FrancoBisciglia/ProyectoFinal_PCB_Prototipo/README.md

# ProyectoFinal_PCB_Prototipo
 PCB de la placa prototipo del Sistema de Automatización para Huertas Hidropónicas NFT
