FrancoBisciglia/ProyectoFinal_PCB_Prototipo/PCB_Prototipo_Proyecto_Final.kicad_pcb

## KiCad design PCB_Prototipo_Proyecto_Final.kicad_pcb (2023-03-13)

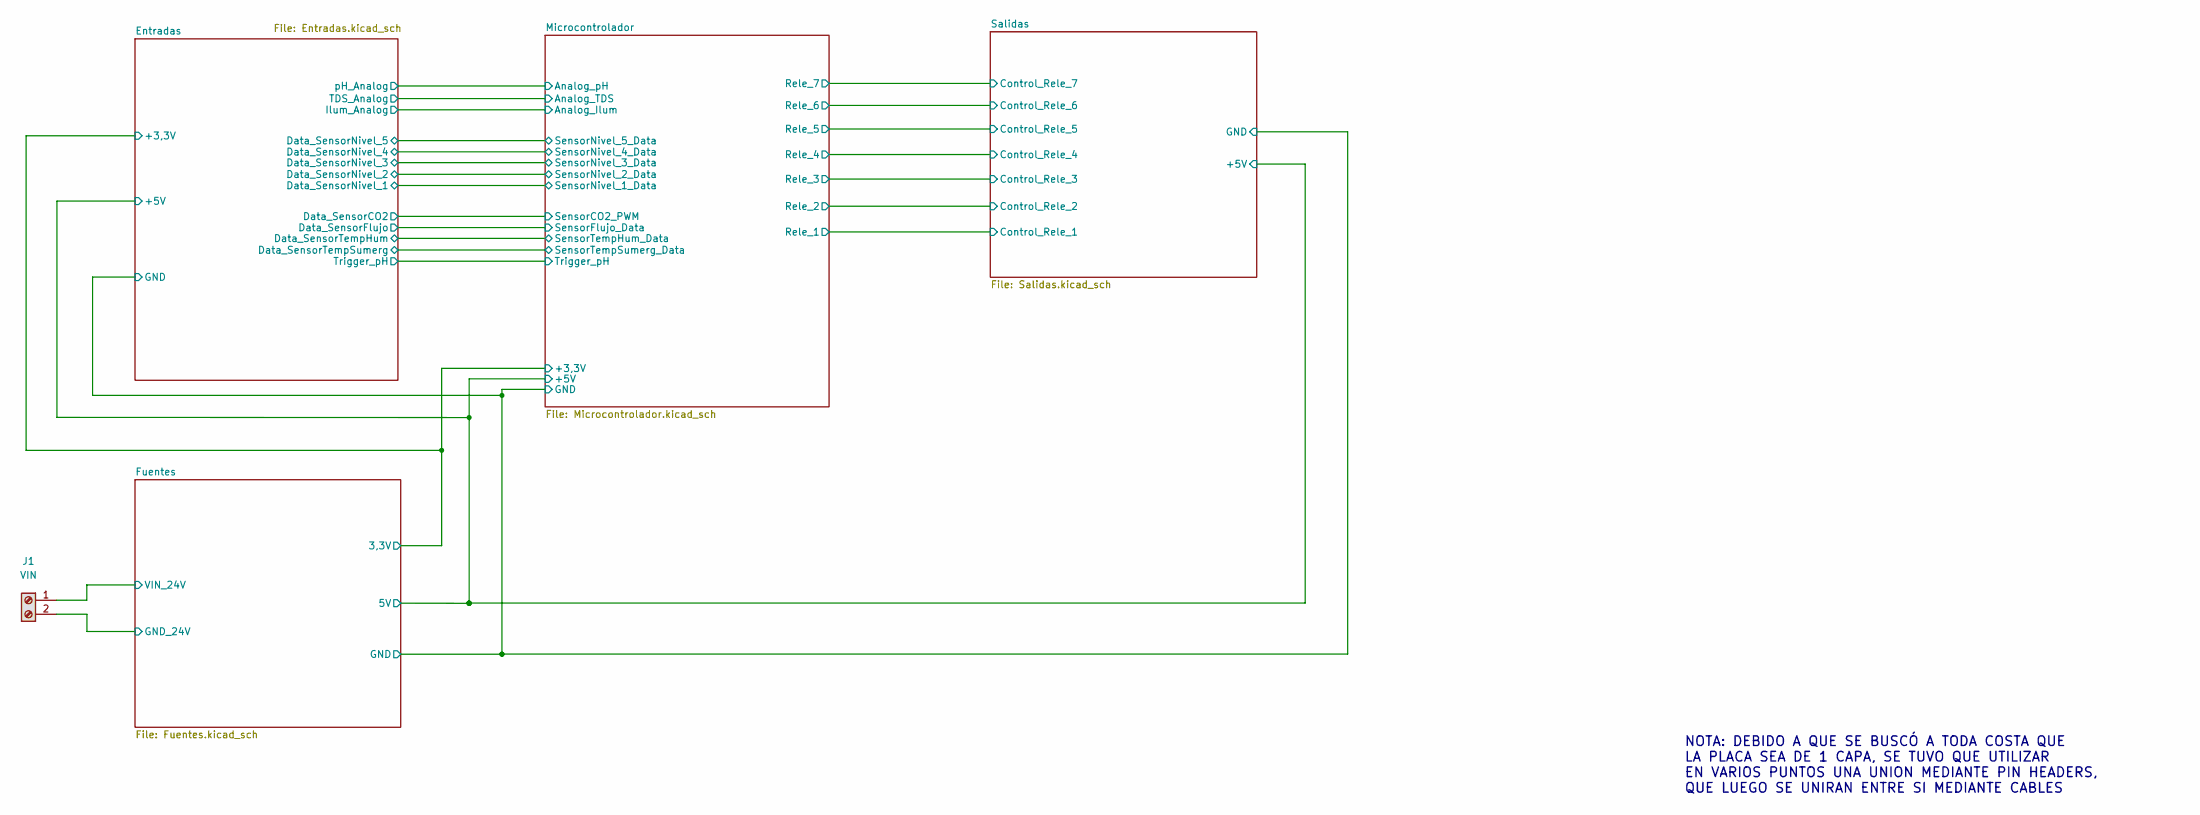
[picture p1: schematic PCB_Prototipo_Proyecto_Final.kicad_sch]

Parts:
J1: VIN; TB00250002BE

Connections:
/Fuentes/VIN_24V: J1.1; also elsewhere on the board
GND: J1.2; also elsewhere on the board

Notes on the sheet:
NOTA: DEBIDO A QUE SE BUSCÓ A TODA COSTA QUE LA PLACA SEA DE 1 CAPA, SE TUVO QUE UTILIZAR EN VARIOS PUNTOS UNA UNION MEDIANTE PIN HEADERS, QUE LUEGO SE UNIRAN ENTRE SI MEDIANTE CABLES

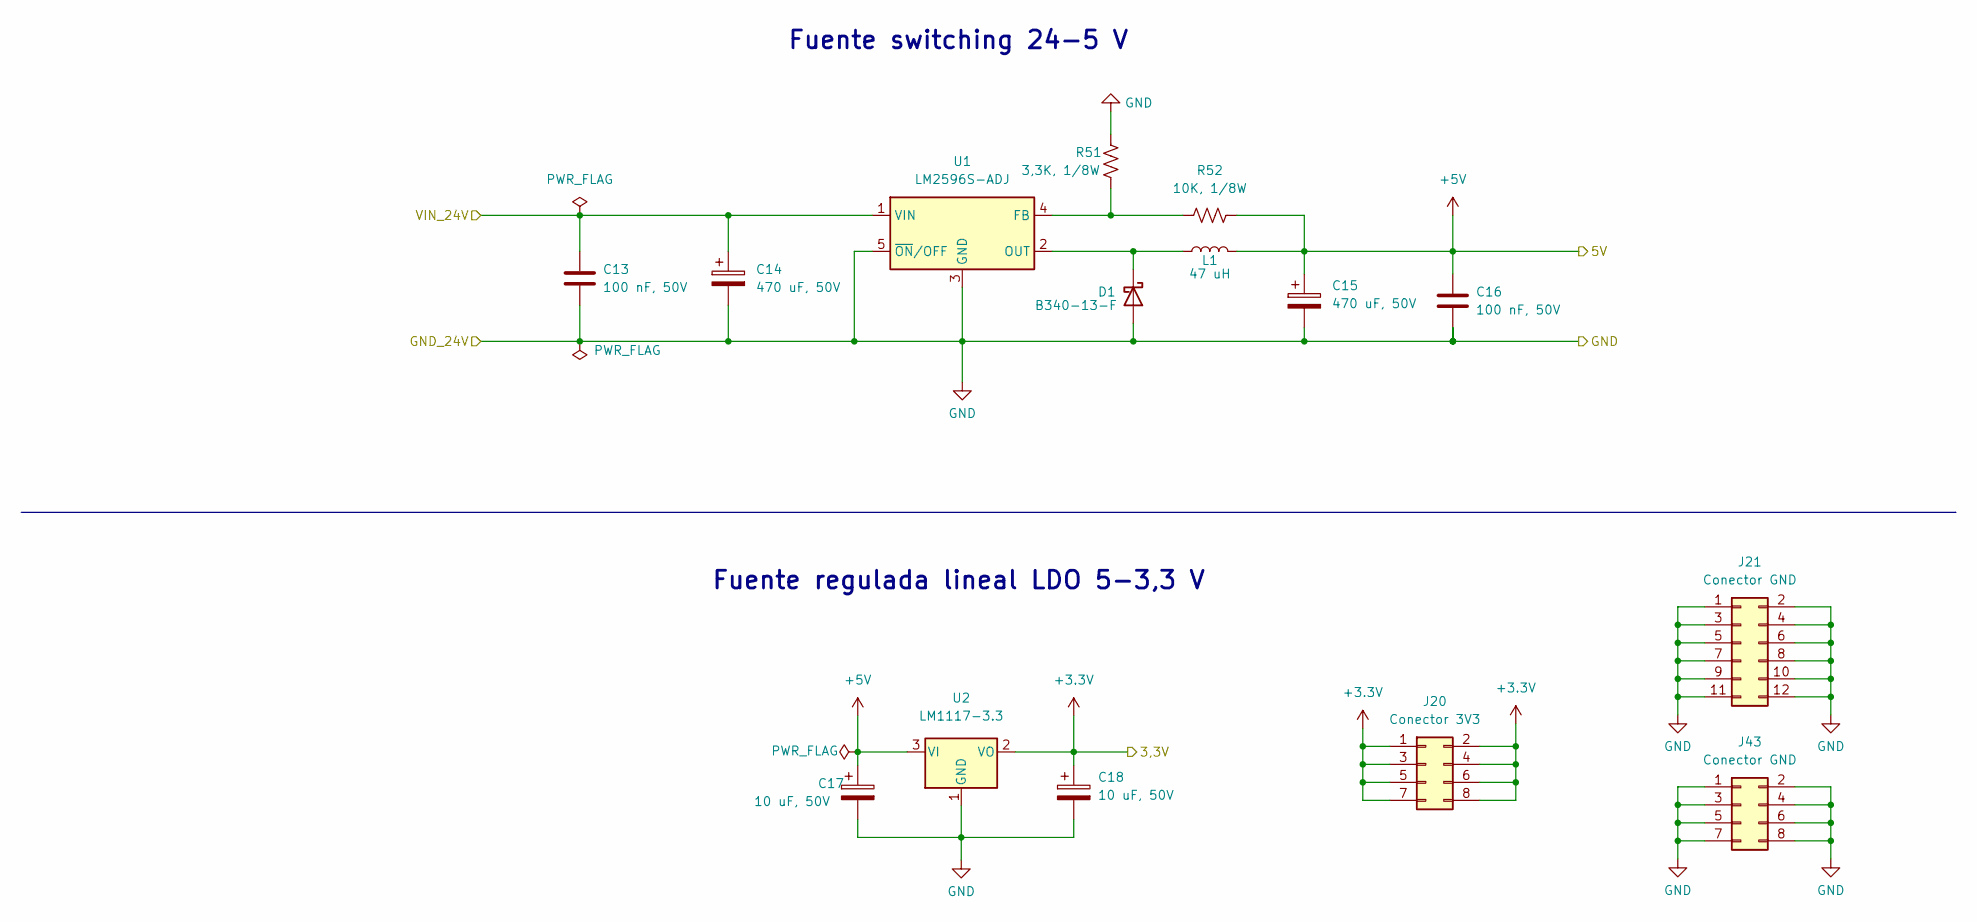
[picture p2: schematic Fuentes.kicad_sch]

Parts:
C13, C16: 100 nF, 50V; C_0805_2012Metric
C14, C15: 470 uF, 50V; CP_Radial_D10.0mm_P5.00mm
C17, C18: 10 uF, 50V; CP_Radial_D5.0mm_P2.00mm
D1: B340-13-F; DIOM7959X250N
J20: Conector 3V3; PinHeader_2x04_P2.54mm_Vertical
J21: Conector GND; PinHeader_2x06_P2.54mm_Vertical
J43: Conector GND; PinHeader_2x04_P2.54mm_Vertical
L1: 47 uH; L_Radial_D7.5mm_P5.00mm_Fastron_07P
R51: 3,3K, 1/8W; R_0805_2012Metric
R52: 10K, 1/8W; R_0805_2012Metric
U1: LM2596S-ADJ; LM2596SXADJNOPB
U2: LM1117-3.3; SOT230P700X180-4N

Connections:
+3.3V: C18.1, J20.1, J20.2, J20.3, J20.4, J20.5, J20.6, J20.7, J20.8, U2.2 (VO); also elsewhere on the board
+5V: C15.1, C16.1, C17.1, L1.2, R52.2, U2.3 (VI); also elsewhere on the board
/Fuentes/VIN_24V: C13.1, C14.1, U1.1 (VIN); also elsewhere on the board
GND: C13.2, C14.2, C15.2, C16.2, C17.2, C18.2, D1.2 (A), J21.1, J21.2, J21.3, J21.4, J21.5, J21.6, J21.7, J21.8, J21.9, J21.10, J21.11, J21.12, J43.1, J43.2, J43.3, J43.4, J43.5, J43.6, J43.7, J43.8, R51.1, U1.3 (GND), U1.5 (~ON/OFF), U2.1 (GND); also elsewhere on the board
unnamed: D1.1 (K), L1.1, U1.2 (OUT)
unnamed: R51.2, R52.1, U1.4 (FB)

Notes on the sheet:
Fuente switching 24-5 V
Fuente regulada lineal LDO 5-3,3 V

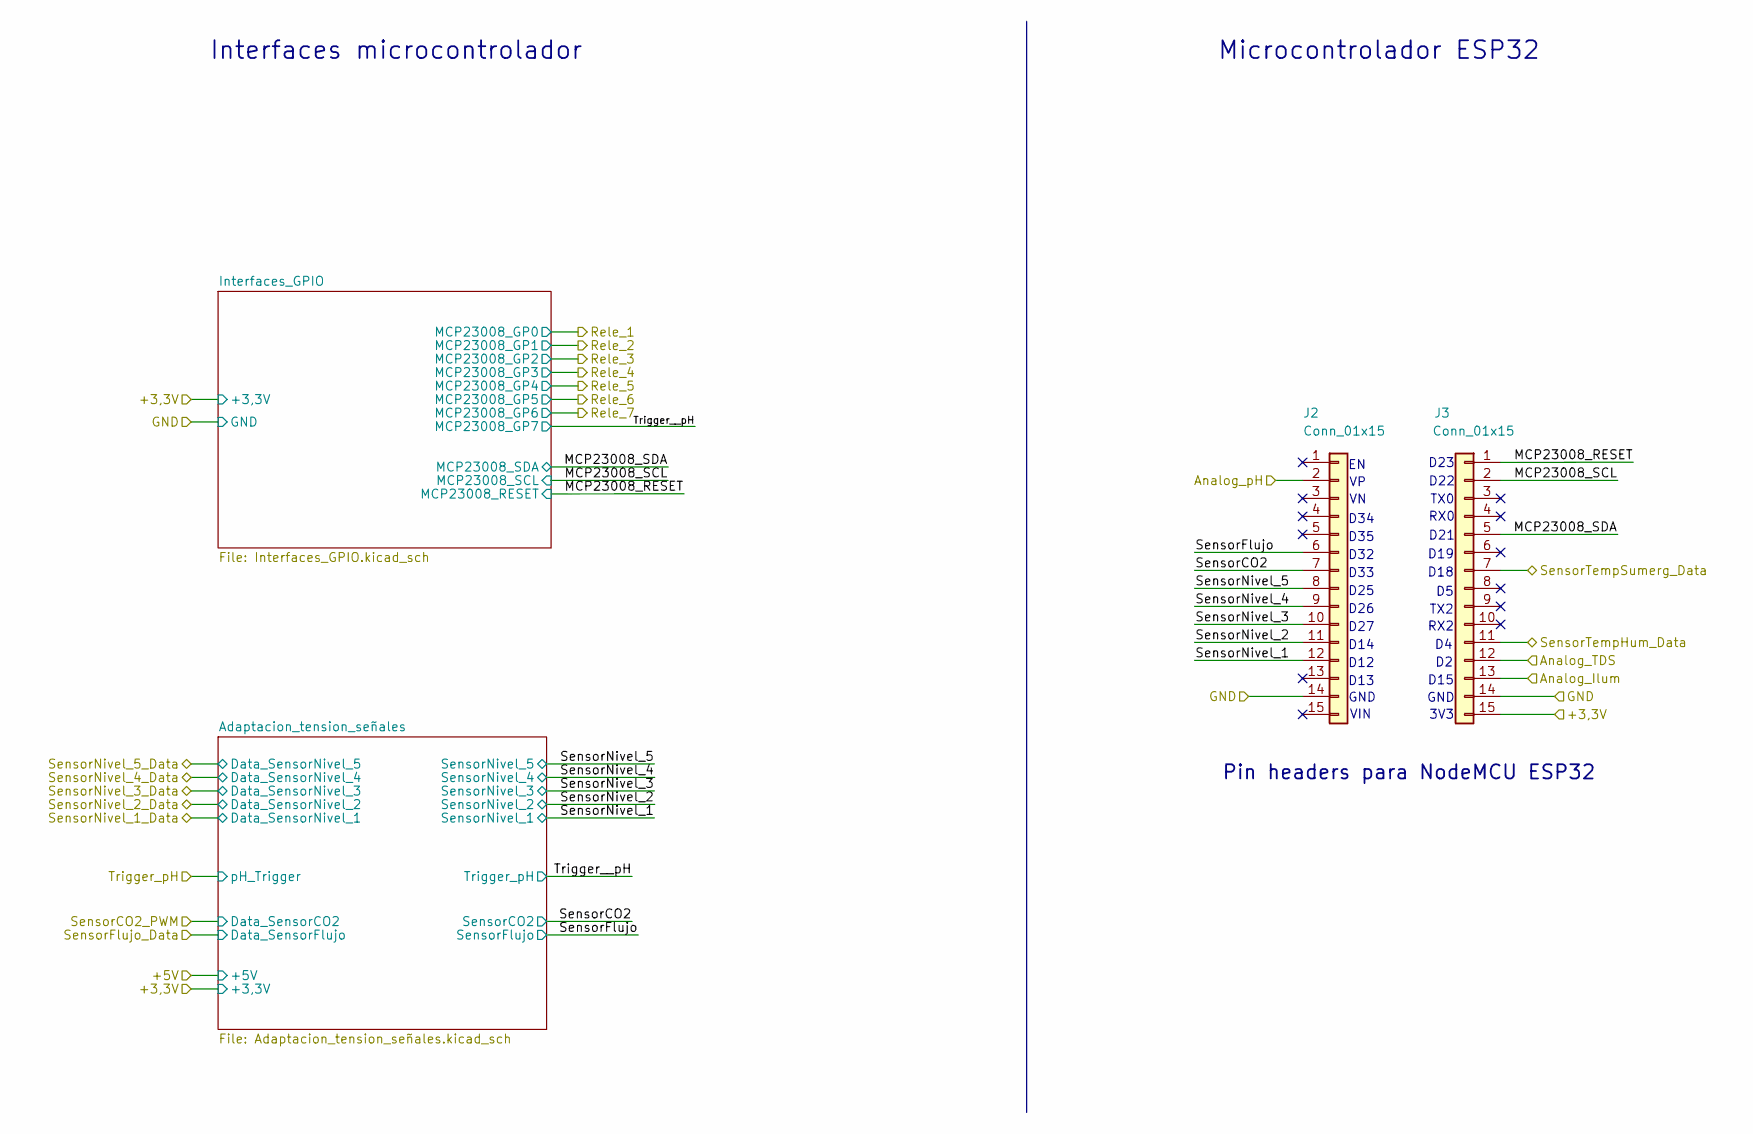
[picture p3: schematic Microcontrolador.kicad_sch]

Parts:
J2, J3: Conn_01x15; PinHeader_1x15_P2.54mm_Vertical

Connections:
+3.3V: J3.15; also elsewhere on the board
/Entradas/Data_SensorTempHum: J3.11; also elsewhere on the board
/Entradas/Data_SensorTempSumerg: J3.7; also elsewhere on the board
/Entradas/Ilum_Analog: J3.13; also elsewhere on the board
/Entradas/TDS_Analog: J3.12; also elsewhere on the board
/Entradas/pH_Analog: J2.2; also elsewhere on the board
/Microcontrolador/MCP23008_RESET: J3.1; also elsewhere on the board
/Microcontrolador/MCP23008_SCL: J3.2; also elsewhere on the board
/Microcontrolador/MCP23008_SDA: J3.5; also elsewhere on the board
/Microcontrolador/SensorCO2: J2.7; also elsewhere on the board
/Microcontrolador/SensorFlujo: J2.6; also elsewhere on the board
/Microcontrolador/SensorNivel_1: J2.12; also elsewhere on the board
/Microcontrolador/SensorNivel_2: J2.11; also elsewhere on the board
/Microcontrolador/SensorNivel_3: J2.10; also elsewhere on the board
/Microcontrolador/SensorNivel_4: J2.9; also elsewhere on the board
/Microcontrolador/SensorNivel_5: J2.8; also elsewhere on the board
GND: J2.14, J3.14; also elsewhere on the board

Notes on the sheet:
GND
RX2
D35
D32
D26
Microcontrolador ESP32
VIN
D18
3V3
D15
D25
D27
Interfaces microcontrolador
RX0
D34
D21
D22
D14
D13
TX0
D12
TX2
D19
D23
D33
Pin headers para NodeMCU ESP32

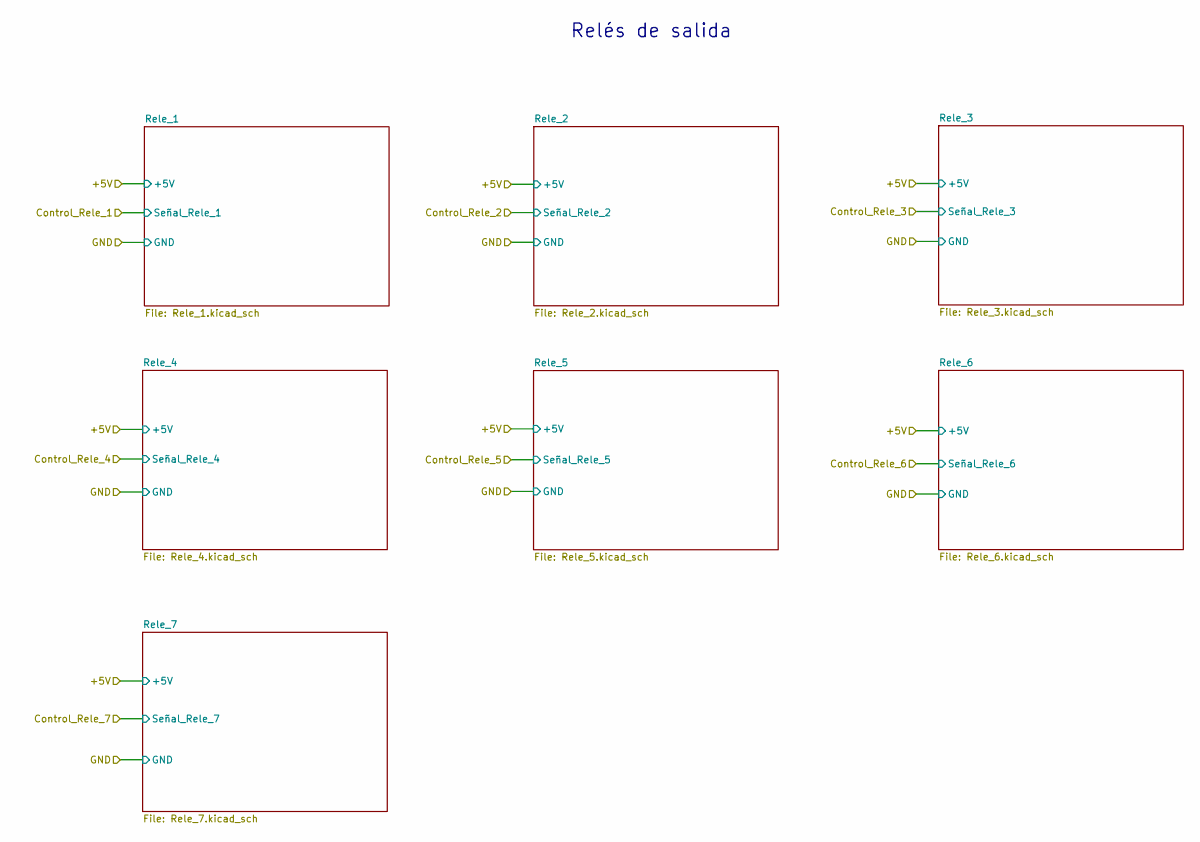
[picture p4: schematic Salidas.kicad_sch]

Notes on the sheet:
Relés de salida

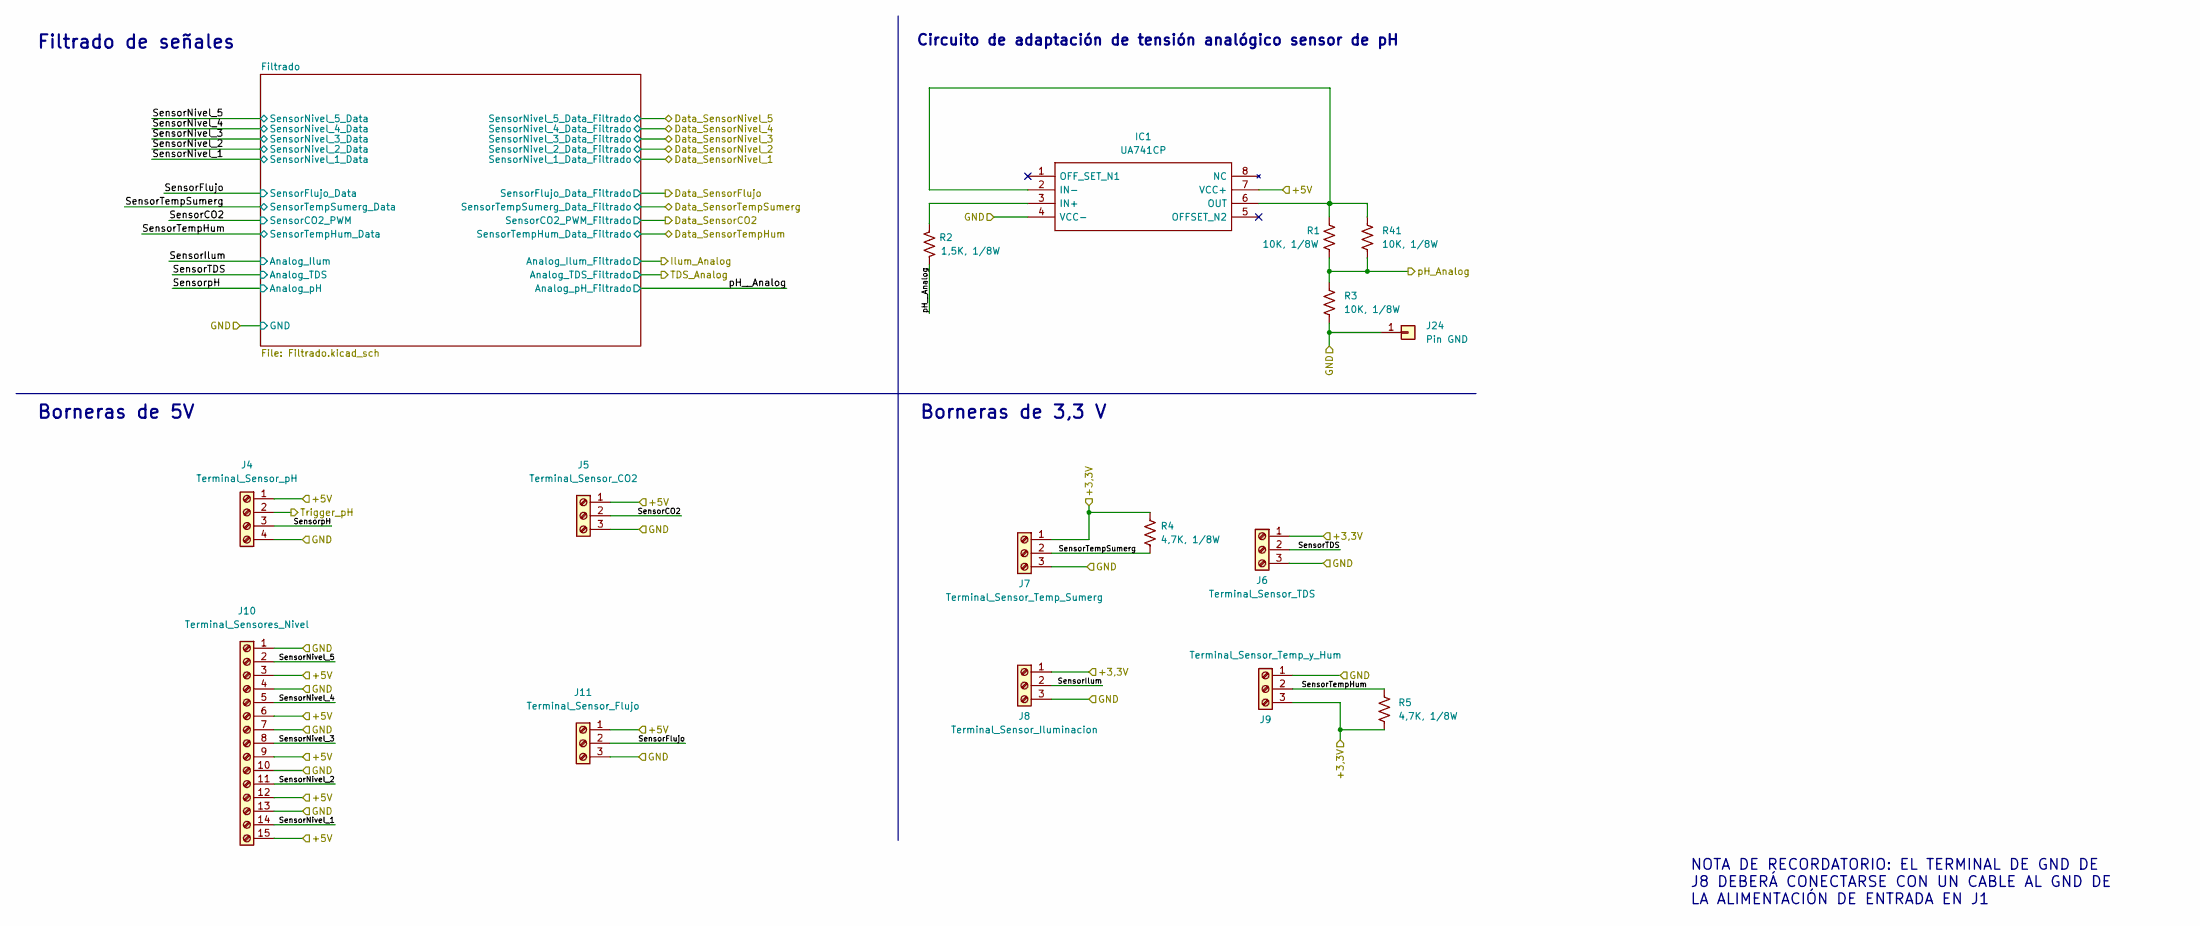
[picture p5: schematic Entradas.kicad_sch]

Parts:
IC1: UA741CP; DIP794W53P254L959H508Q8N; Manufacturer_Part_Number UA741CP; Mouser Part Number 595-UA741CP
J4: Terminal_Sensor_pH; TB00150004BE
J5: Terminal_Sensor_CO2; SHDR3W100P0X500_1X3_1500X760X1000P
J6: Terminal_Sensor_TDS; SHDR3W100P0X500_1X3_1500X760X1000P
J7: Terminal_Sensor_Temp_Sumerg; SHDR3W100P0X500_1X3_1500X760X1000P
J8: Terminal_Sensor_Iluminacion; SHDR3W100P0X500_1X3_1500X760X1000P
J9: Terminal_Sensor_Temp_y_Hum; SHDR3W100P0X500_1X3_1500X760X1000P
J10: Terminal_Sensores_Nivel; CUI_TB002-500-15BE
J11: Terminal_Sensor_Flujo; SHDR3W100P0X500_1X3_1500X760X1000P
J24: Pin GND; PinHeader_1x01_P2.54mm_Vertical
R1, R3, R41: 10K, 1/8W; R_0805_2012Metric
R2: 1,5K, 1/8W; R_0805_2012Metric
R4, R5: 4,7K, 1/8W; R_0805_2012Metric

Connections:
+3.3V: J6.1, J7.1, J8.1, J9.3, R4.1, R5.1; also elsewhere on the board
+5V: IC1.7 (VCC+), J4.1, J5.1, J10.3, J10.6, J10.9, J10.12, J10.15, J11.1; also elsewhere on the board
/Entradas/SensorCO2: J5.2; also elsewhere on the board
/Entradas/SensorFlujo: J11.2; also elsewhere on the board
/Entradas/SensorIlum: J8.2; also elsewhere on the board
/Entradas/SensorNivel_1: J10.14; also elsewhere on the board
/Entradas/SensorNivel_2: J10.11; also elsewhere on the board
/Entradas/SensorNivel_3: J10.8; also elsewhere on the board
/Entradas/SensorNivel_4: J10.5; also elsewhere on the board
/Entradas/SensorNivel_5: J10.2; also elsewhere on the board
/Entradas/SensorTDS: J6.2; also elsewhere on the board
/Entradas/SensorTempHum: J9.2, R5.2; also elsewhere on the board
/Entradas/SensorTempSumerg: J7.2, R4.2; also elsewhere on the board
/Entradas/SensorpH: J4.3; also elsewhere on the board
/Entradas/Trigger_pH: J4.2; also elsewhere on the board
/Entradas/pH_Analog: R1.2, R3.1, R41.2; also elsewhere on the board
/Entradas/pH__Analog: R2.2; also elsewhere on the board
GND: IC1.4 (VCC-), J4.4, J5.3, J6.3, J7.3, J8.3, J9.1, J10.1, J10.4, J10.7, J10.10, J10.13, J11.3, J24.1, R3.2; also elsewhere on the board
unnamed: IC1.2 (IN-), IC1.6 (OUT), R1.1, R41.1
unnamed: IC1.3 (IN+), R2.1

Notes on the sheet:
Filtrado de señales
NOTA DE RECORDATORIO: EL TERMINAL DE GND DE J8 DEBERÁ CONECTARSE CON UN CABLE AL GND DE LA ALIMENTACIÓN DE ENTRADA EN J1
Borneras de 5V
Borneras de 3,3 V
Circuito de adaptación de tensión analógico sensor de pH

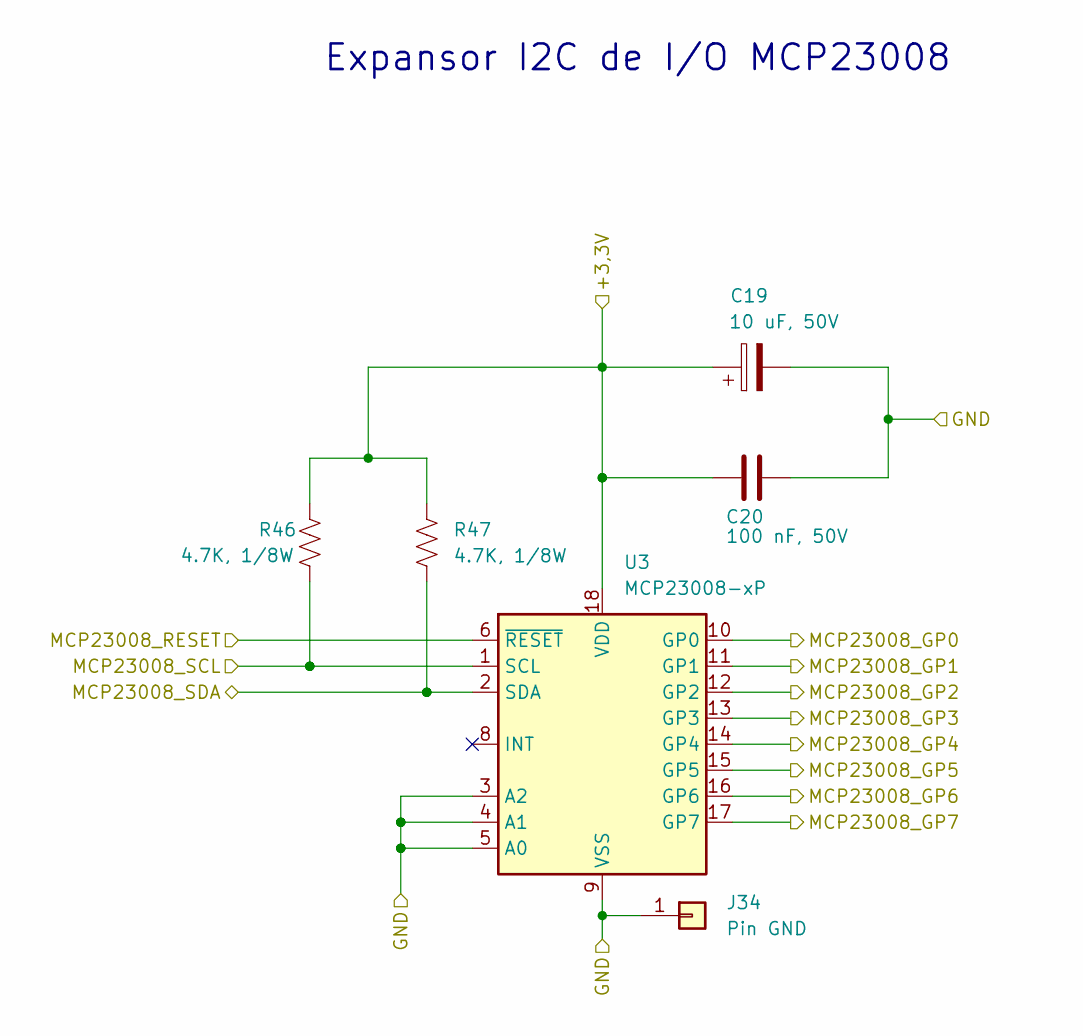
[picture p6: schematic Interfaces_GPIO.kicad_sch]

Parts:
C19: 10 uF, 50V; CP_Radial_D5.0mm_P2.00mm
C20: 100 nF, 50V; C_0805_2012Metric
J34: Pin GND; PinHeader_1x01_P2.54mm_Vertical
R46, R47: 4.7K, 1/8W; R_0805_2012Metric
U3: MCP23008-xP; DIP-18_W7.62mm

Connections:
+3.3V: C19.1, C20.1, R46.1, R47.1, U3.18 (VDD); also elsewhere on the board
/Microcontrolador/MCP23008_RESET: U3.6 (~RESET); also elsewhere on the board
/Microcontrolador/MCP23008_SCL: R46.2, U3.1 (SCL); also elsewhere on the board
/Microcontrolador/MCP23008_SDA: R47.2, U3.2 (SDA); also elsewhere on the board
/Microcontrolador/Rele_1: U3.10 (GP0); also elsewhere on the board
/Microcontrolador/Rele_2: U3.11 (GP1); also elsewhere on the board
/Microcontrolador/Rele_3: U3.12 (GP2); also elsewhere on the board
/Microcontrolador/Rele_4: U3.13 (GP3); also elsewhere on the board
/Microcontrolador/Rele_5: U3.14 (GP4); also elsewhere on the board
/Microcontrolador/Rele_6: U3.15 (GP5); also elsewhere on the board
/Microcontrolador/Rele_7: U3.16 (GP6); also elsewhere on the board
/Microcontrolador/Trigger__pH: U3.17 (GP7); also elsewhere on the board
GND: C19.2, C20.2, J34.1, U3.3 (A2), U3.4 (A1), U3.5 (A0), U3.9 (VSS); also elsewhere on the board

Notes on the sheet:
Expansor I2C de I/O MCP23008

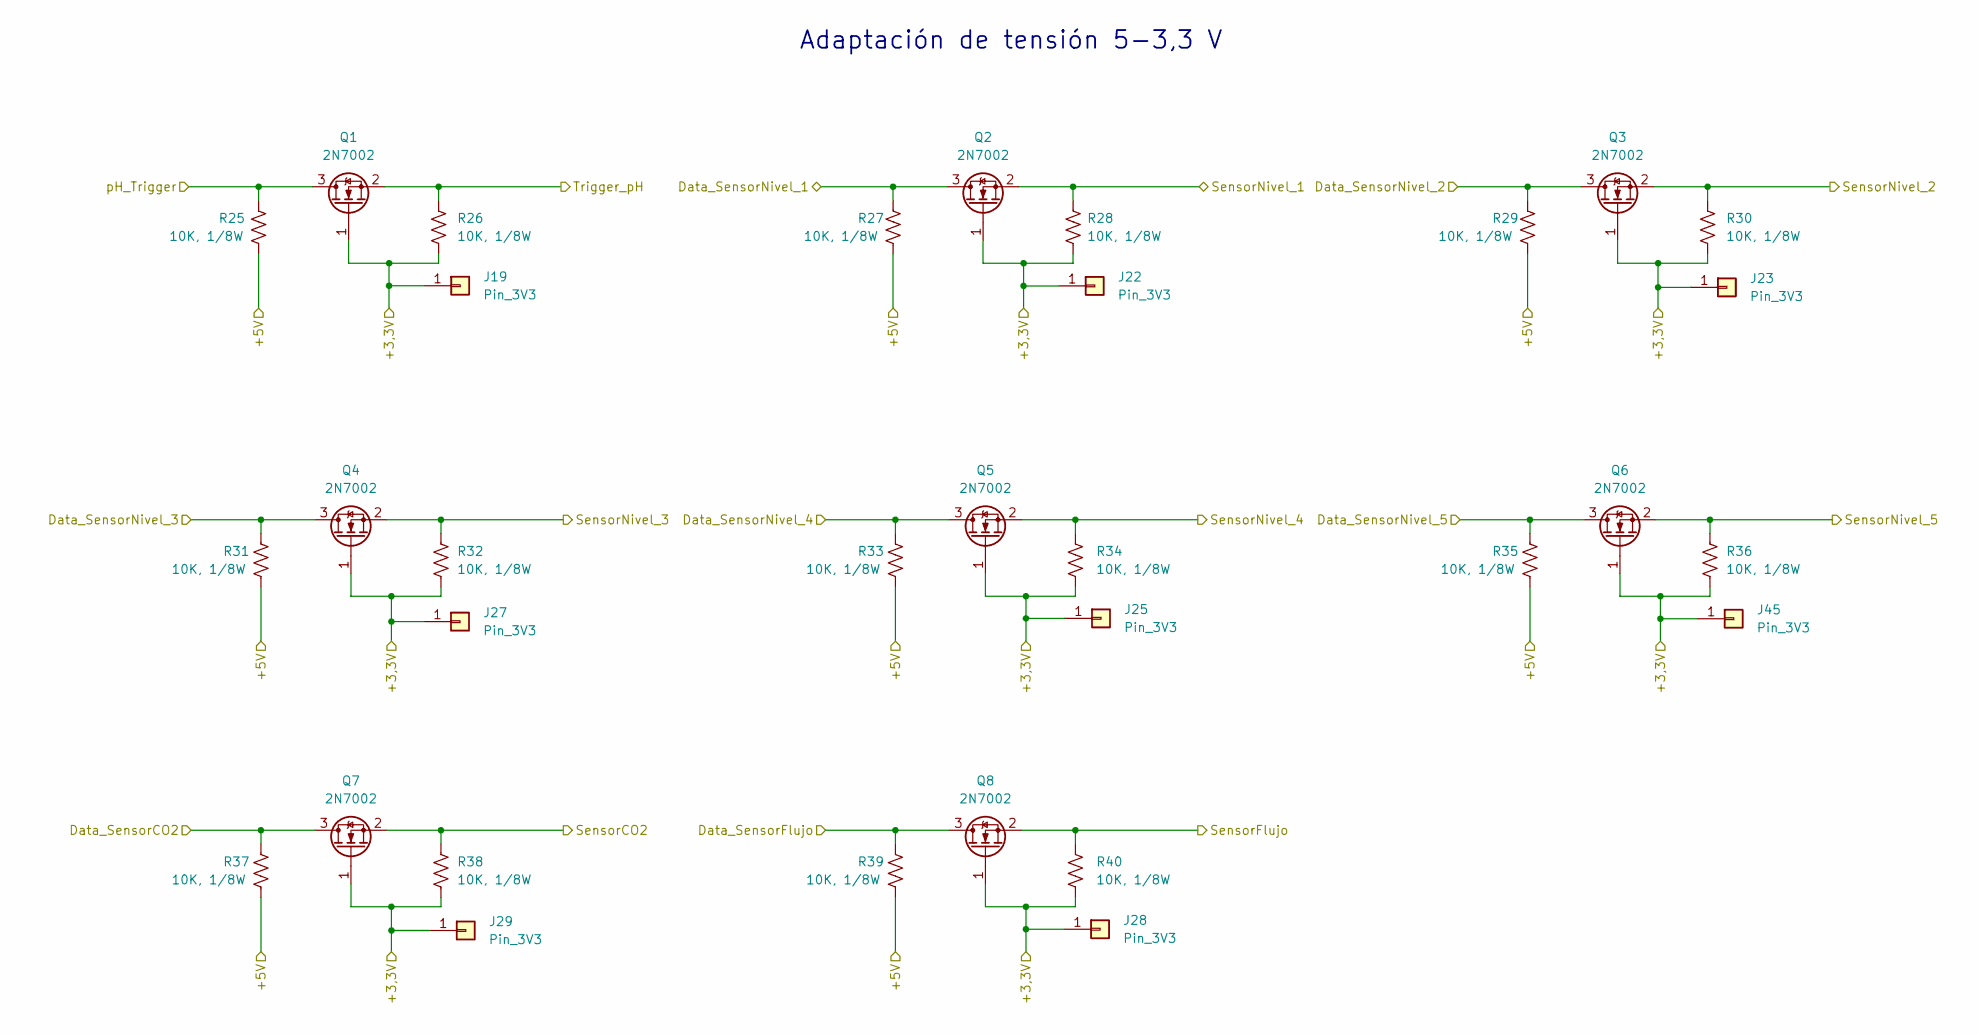
[picture p7: schematic Adaptacion_tension_señales.kicad_sch]

Parts:
J19, J22, J23, J25, J27, J28, J29, J45: Pin_3V3; PinHeader_1x01_P2.54mm_Vertical
Q1, Q2, Q3, Q4, Q5, Q6, Q7, Q8: 2N7002; SOT-23
R25, R26, R27, R28, R29, R30, R31, R32, R33, R34, R35, R36, R37, R38, R39, R40: 10K, 1/8W; R_0805_2012Metric

Connections:
+3.3V: J19.1, J22.1, J23.1, J25.1, J27.1, J28.1, J29.1, J45.1, Q1.1 (G), Q2.1 (G), Q3.1 (G), Q4.1 (G), Q5.1 (G), Q6.1 (G), Q7.1 (G), Q8.1 (G), R26.2, R28.2, R30.2, R32.2, R34.2, R36.2, R38.2, R40.2; also elsewhere on the board
+5V: R25.2, R27.2, R29.2, R31.2, R33.2, R35.2, R37.2, R39.2; also elsewhere on the board
/Entradas/Data_SensorCO2: Q7.3 (D), R37.1; also elsewhere on the board
/Entradas/Data_SensorFlujo: Q8.3 (D), R39.1; also elsewhere on the board
/Entradas/Data_SensorNivel_1: Q2.3 (D), R27.1; also elsewhere on the board
/Entradas/Data_SensorNivel_2: Q3.3 (D), R29.1; also elsewhere on the board
/Entradas/Data_SensorNivel_3: Q4.3 (D), R31.1; also elsewhere on the board
/Entradas/Data_SensorNivel_4: Q5.3 (D), R33.1; also elsewhere on the board
/Entradas/Data_SensorNivel_5: Q6.3 (D), R35.1; also elsewhere on the board
/Entradas/Trigger_pH: Q1.3 (D), R25.1; also elsewhere on the board
/Microcontrolador/SensorCO2: Q7.2 (S), R38.1; also elsewhere on the board
/Microcontrolador/SensorFlujo: Q8.2 (S), R40.1; also elsewhere on the board
/Microcontrolador/SensorNivel_1: Q2.2 (S), R28.1; also elsewhere on the board
/Microcontrolador/SensorNivel_2: Q3.2 (S), R30.1; also elsewhere on the board
/Microcontrolador/SensorNivel_3: Q4.2 (S), R32.1; also elsewhere on the board
/Microcontrolador/SensorNivel_4: Q5.2 (S), R34.1; also elsewhere on the board
/Microcontrolador/SensorNivel_5: Q6.2 (S), R36.1; also elsewhere on the board
/Microcontrolador/Trigger__pH: Q1.2 (S), R26.1; also elsewhere on the board

Notes on the sheet:
Adaptación de tensión 5-3,3 V

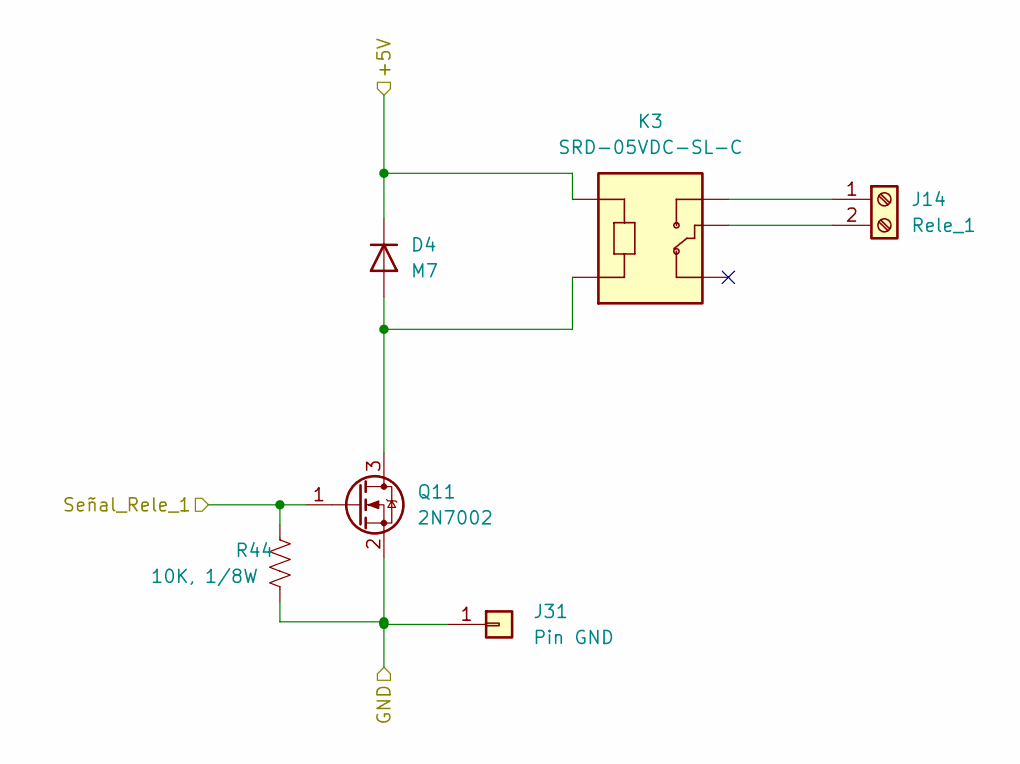
[picture p8: schematic Rele_1.kicad_sch]

Parts:
D4: M7; D_SMA
J14: Rele_1; TB00250002BE
J31: Pin GND; PinHeader_1x01_P2.54mm_Vertical
K3: SRD-05VDC-SL-C; RELAY_SRD-05VDC-SL-C
Q11: 2N7002; SOT-23
R44: 10K, 1/8W; R_0805_2012Metric

Connections:
+5V: D4.1 (K), K3.A1; also elsewhere on the board
/Microcontrolador/Rele_1: Q11.1 (G), R44.1; also elsewhere on the board
GND: J31.1, Q11.2 (S), R44.2; also elsewhere on the board
unnamed: D4.2 (A), K3.A2, Q11.3 (D)
unnamed: J14.1, K3.NO
unnamed: J14.2, K3.COM

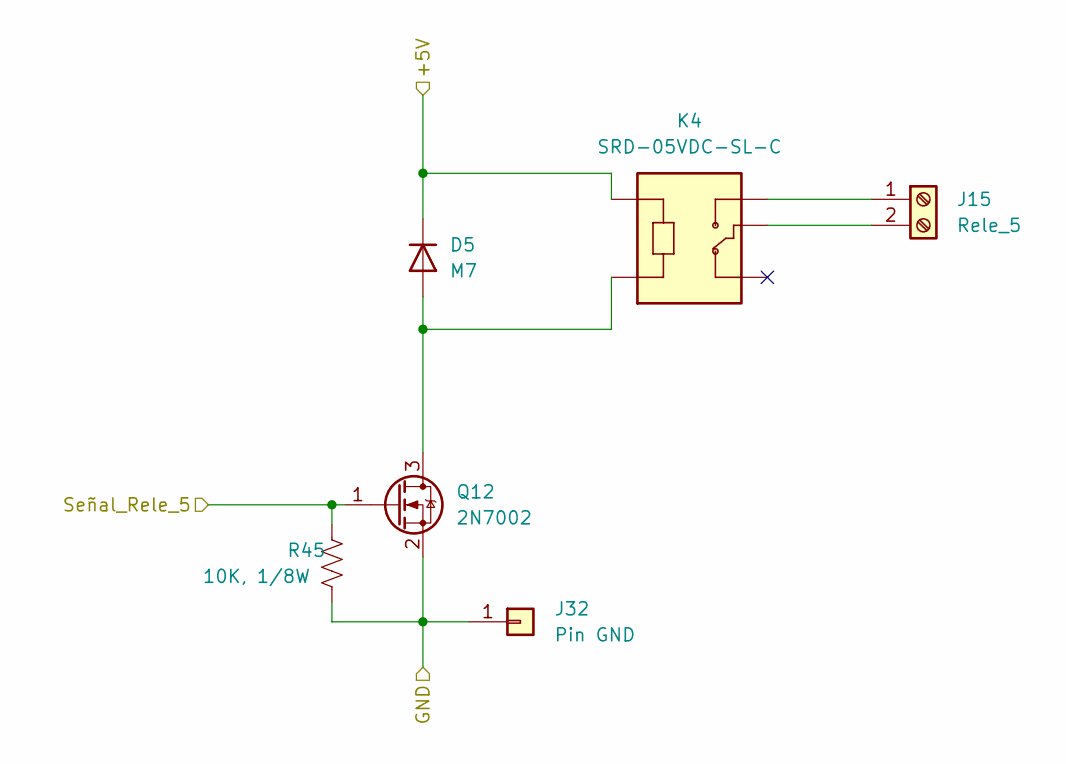
[picture p9: schematic Rele_5.kicad_sch]

Parts:
D5: M7; D_SMA
J15: Rele_5; TB00250002BE
J32: Pin GND; PinHeader_1x01_P2.54mm_Vertical
K4: SRD-05VDC-SL-C; RELAY_SRD-05VDC-SL-C
Q12: 2N7002; SOT-23
R45: 10K, 1/8W; R_0805_2012Metric

Connections:
+5V: D5.1 (K), K4.A1; also elsewhere on the board
/Microcontrolador/Rele_5: Q12.1 (G), R45.1; also elsewhere on the board
GND: J32.1, Q12.2 (S), R45.2; also elsewhere on the board
unnamed: D5.2 (A), K4.A2, Q12.3 (D)
unnamed: J15.1, K4.NO
unnamed: J15.2, K4.COM

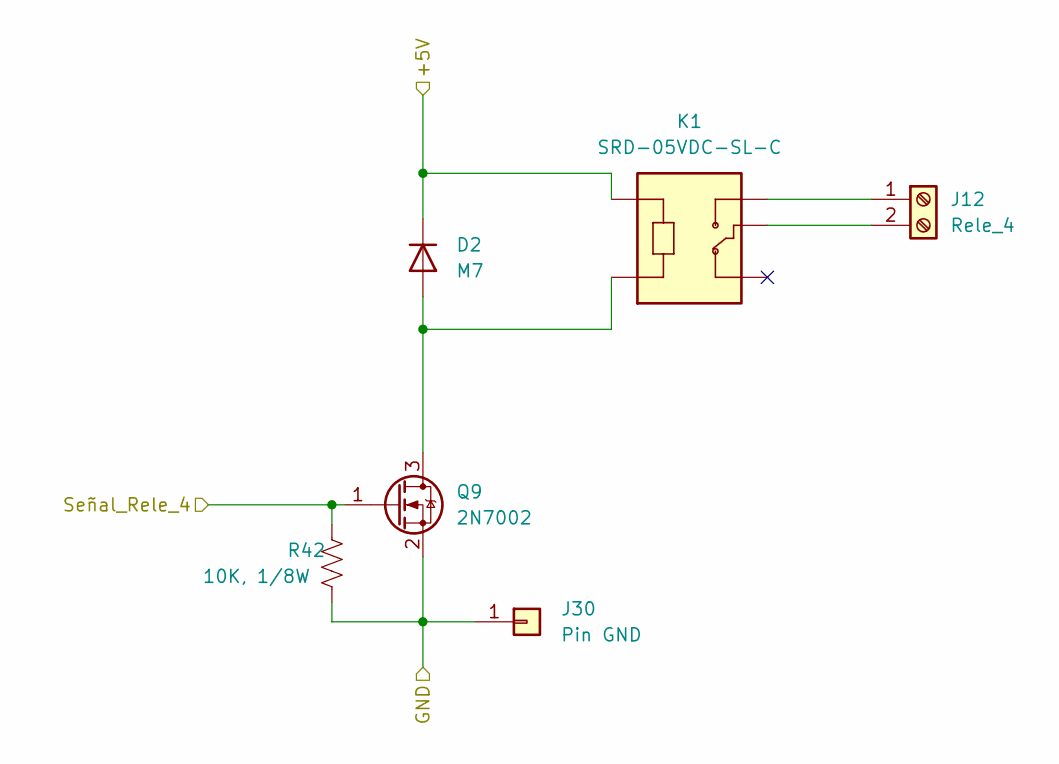
[picture p10: schematic Rele_4.kicad_sch]

Parts:
D2: M7; D_SMA
J12: Rele_4; TB00250002BE
J30: Pin GND; PinHeader_1x01_P2.54mm_Vertical
K1: SRD-05VDC-SL-C; RELAY_SRD-05VDC-SL-C
Q9: 2N7002; SOT-23
R42: 10K, 1/8W; R_0805_2012Metric

Connections:
+5V: D2.1 (K), K1.A1; also elsewhere on the board
/Microcontrolador/Rele_4: Q9.1 (G), R42.1; also elsewhere on the board
GND: J30.1, Q9.2 (S), R42.2; also elsewhere on the board
unnamed: D2.2 (A), K1.A2, Q9.3 (D)
unnamed: J12.1, K1.NO
unnamed: J12.2, K1.COM

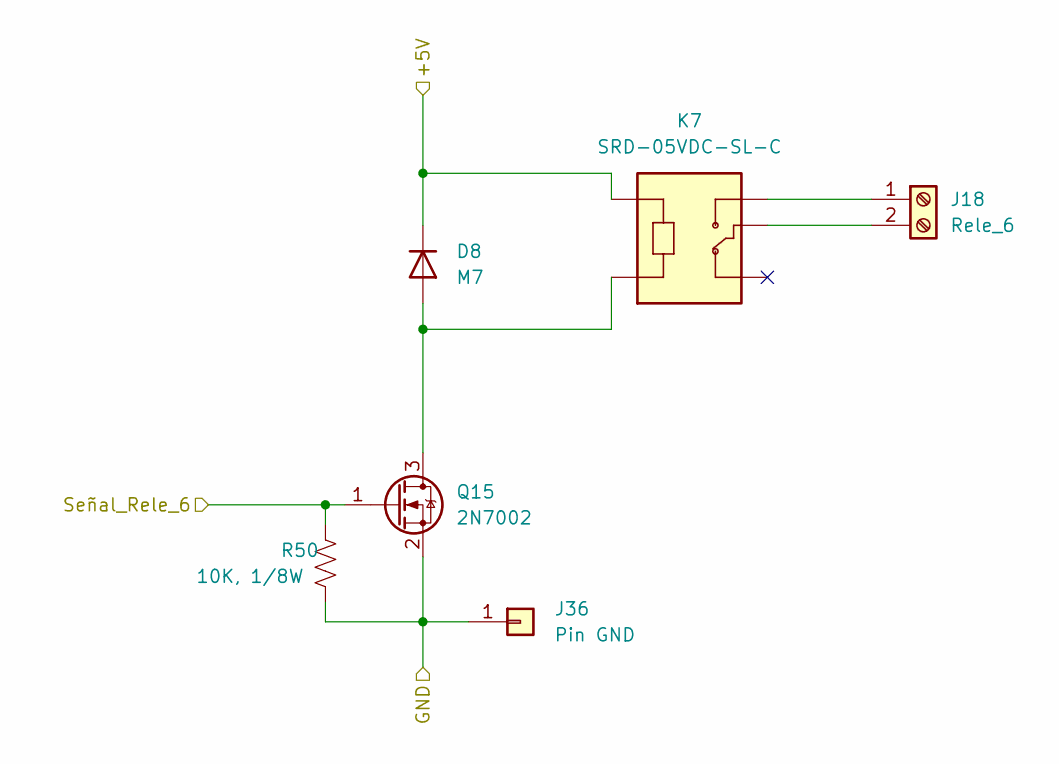
[picture p11: schematic Rele_6.kicad_sch]

Parts:
D8: M7; D_SMA
J18: Rele_6; TB00250002BE
J36: Pin GND; PinHeader_1x01_P2.54mm_Vertical
K7: SRD-05VDC-SL-C; RELAY_SRD-05VDC-SL-C
Q15: 2N7002; SOT-23
R50: 10K, 1/8W; R_0805_2012Metric

Connections:
+5V: D8.1 (K), K7.A1; also elsewhere on the board
/Microcontrolador/Rele_6: Q15.1 (G), R50.1; also elsewhere on the board
GND: J36.1, Q15.2 (S), R50.2; also elsewhere on the board
unnamed: D8.2 (A), K7.A2, Q15.3 (D)
unnamed: J18.1, K7.NO
unnamed: J18.2, K7.COM

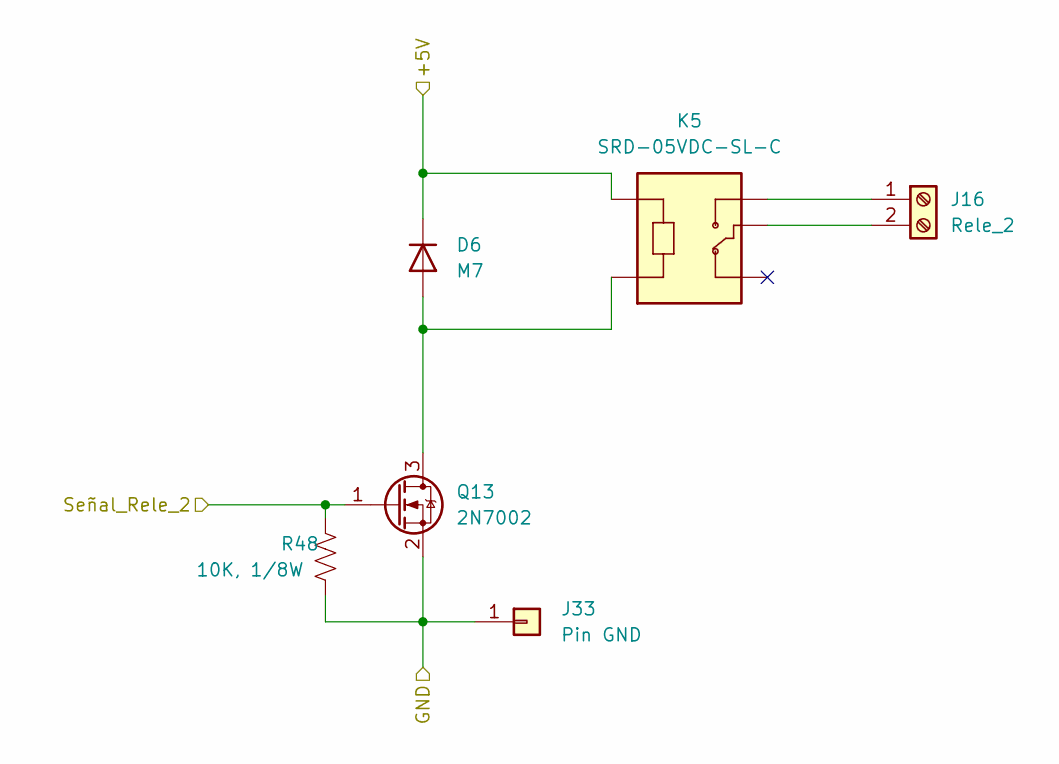
[picture p12: schematic Rele_2.kicad_sch]

Parts:
D6: M7; D_SMA
J16: Rele_2; TB00250002BE
J33: Pin GND; PinHeader_1x01_P2.54mm_Vertical
K5: SRD-05VDC-SL-C; RELAY_SRD-05VDC-SL-C
Q13: 2N7002; SOT-23
R48: 10K, 1/8W; R_0805_2012Metric

Connections:
+5V: D6.1 (K), K5.A1; also elsewhere on the board
/Microcontrolador/Rele_2: Q13.1 (G), R48.1; also elsewhere on the board
GND: J33.1, Q13.2 (S), R48.2; also elsewhere on the board
unnamed: D6.2 (A), K5.A2, Q13.3 (D)
unnamed: J16.1, K5.NO
unnamed: J16.2, K5.COM
