FrancoBisciglia/ProyectoFinal_PCB_Prototipo/PCB_Prototipo_Proyecto_Final.kicad_pcb

## KiCad design PCB_Prototipo_Proyecto_Final.kicad_pcb (continued)

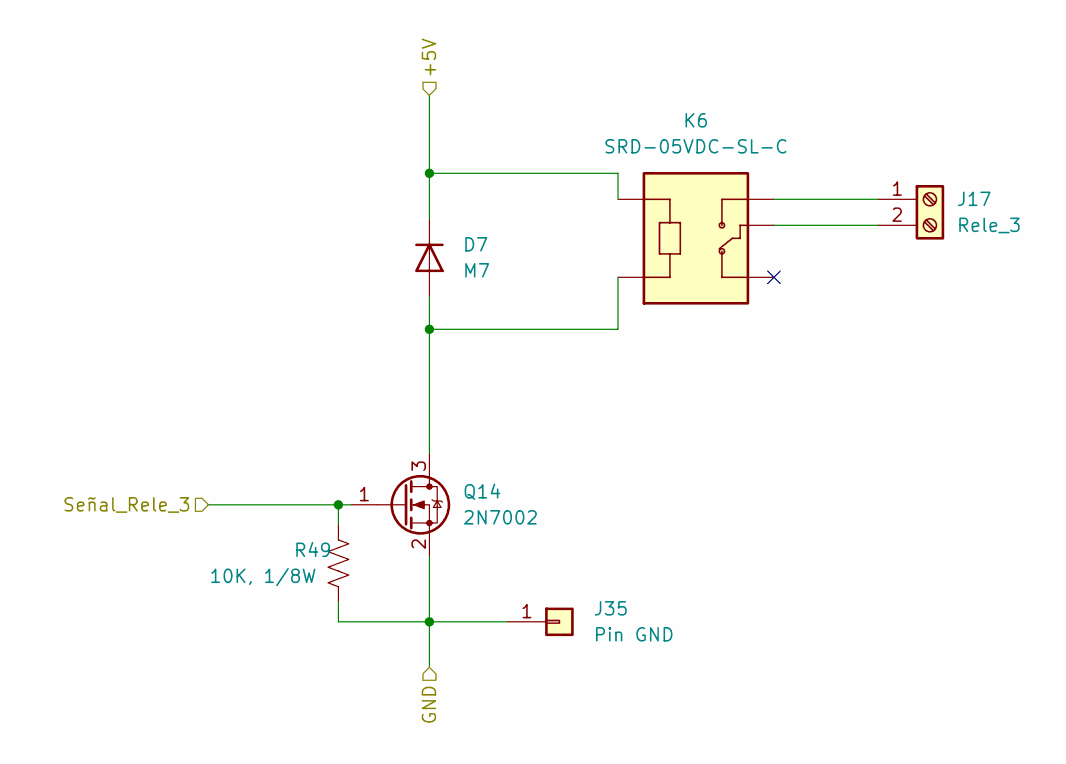
[picture p13: schematic Rele_3.kicad_sch]

Parts:
D7: M7; D_SMA
J17: Rele_3; TB00250002BE
J35: Pin GND; PinHeader_1x01_P2.54mm_Vertical
K6: SRD-05VDC-SL-C; RELAY_SRD-05VDC-SL-C
Q14: 2N7002; SOT-23
R49: 10K, 1/8W; R_0805_2012Metric

Connections:
+5V: D7.1 (K), K6.A1; also elsewhere on the board
/Microcontrolador/Rele_3: Q14.1 (G), R49.1; also elsewhere on the board
GND: J35.1, Q14.2 (S), R49.2; also elsewhere on the board
unnamed: D7.2 (A), K6.A2, Q14.3 (D)
unnamed: J17.1, K6.NO
unnamed: J17.2, K6.COM

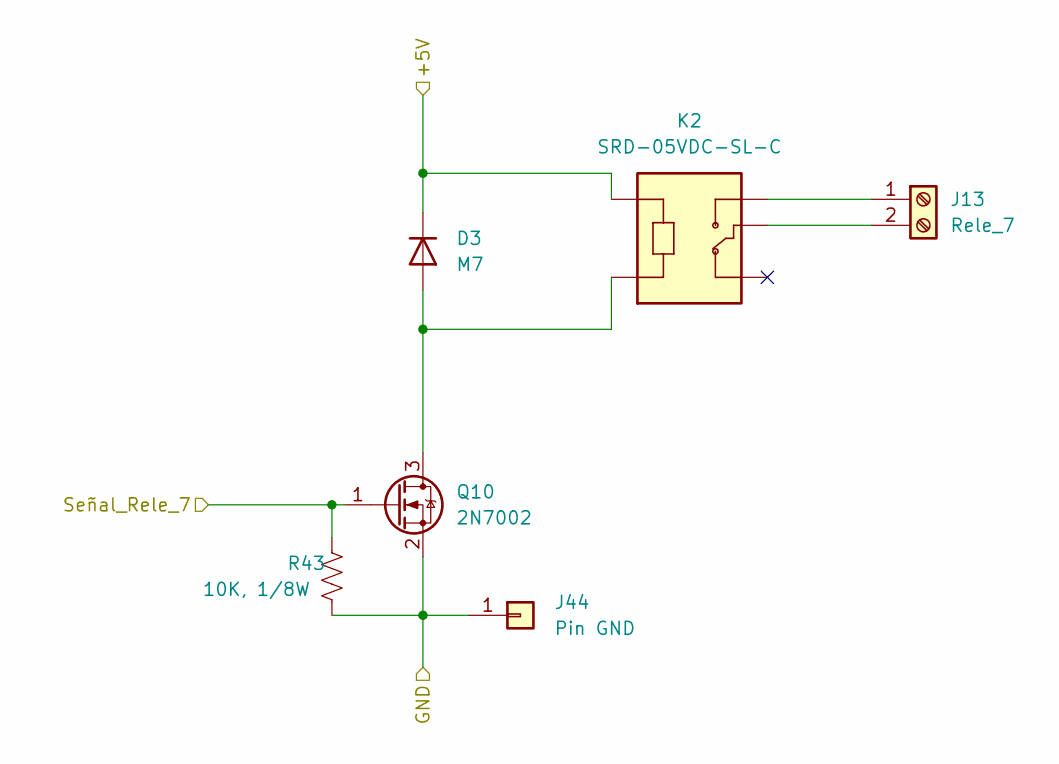
[picture p14: schematic Rele_7.kicad_sch]

Parts:
D3: M7; D_SMA
J13: Rele_7; TB00250002BE
J44: Pin GND; PinHeader_1x01_P2.54mm_Vertical
K2: SRD-05VDC-SL-C; RELAY_SRD-05VDC-SL-C
Q10: 2N7002; SOT-23
R43: 10K, 1/8W; R_0805_2012Metric

Connections:
+5V: D3.1 (K), K2.A1; also elsewhere on the board
/Microcontrolador/Rele_7: Q10.1 (G), R43.1; also elsewhere on the board
GND: J44.1, Q10.2 (S), R43.2; also elsewhere on the board
unnamed: D3.2 (A), K2.A2, Q10.3 (D)
unnamed: J13.1, K2.NO
unnamed: J13.2, K2.COM

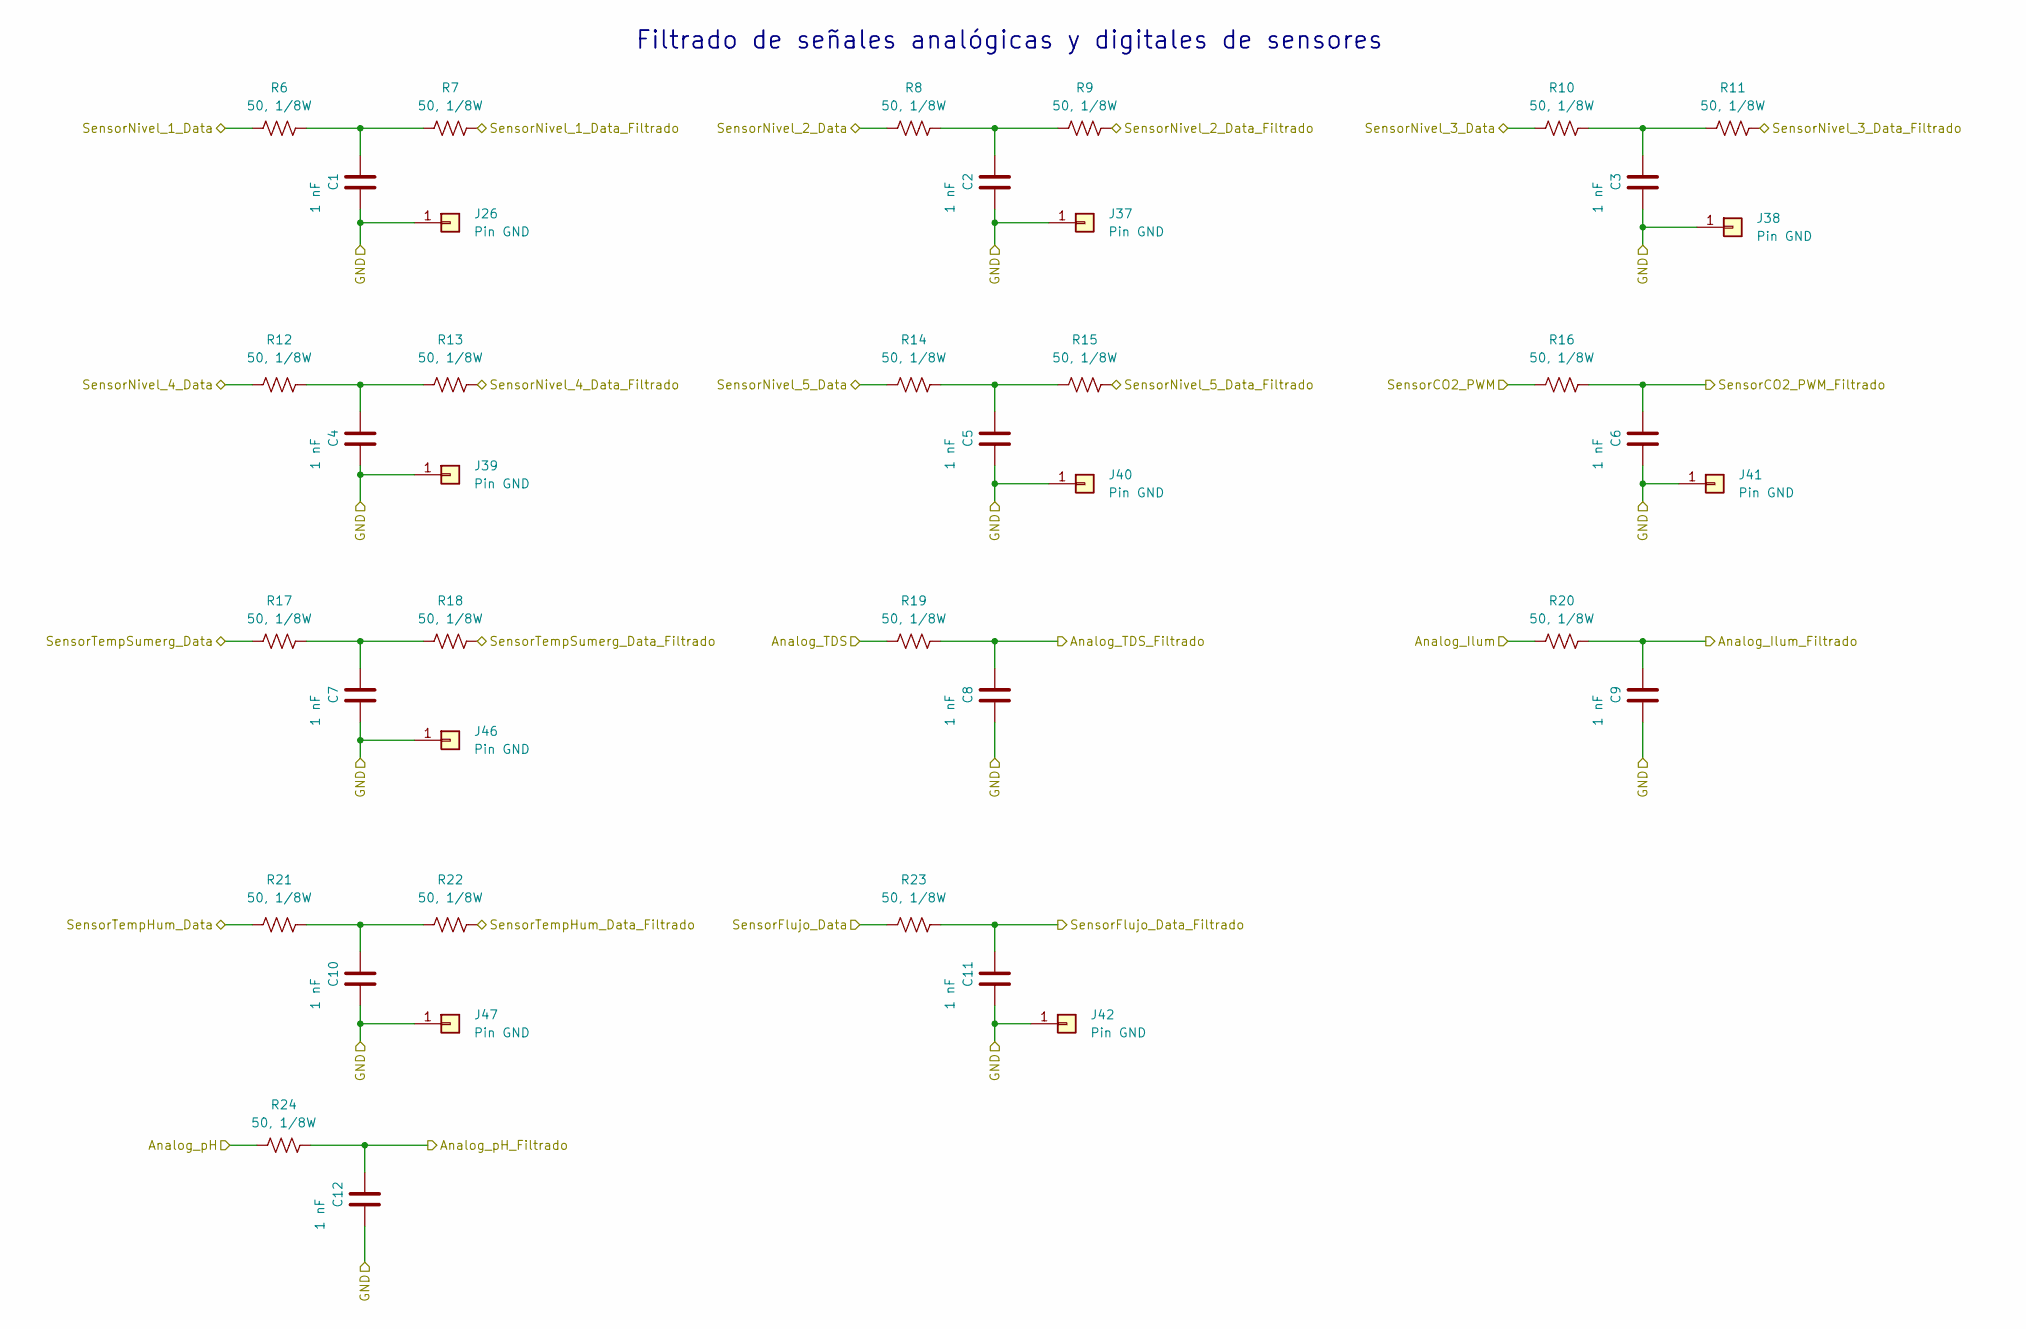
[picture p15: schematic Filtrado.kicad_sch]

Parts:
C1, C2, C3, C4, C5, C6, C7, C8, C9, C10, C11, C12: 1 nF; C_0805_2012Metric
J26, J37, J38, J39, J40, J41, J42, J46, J47: Pin GND; PinHeader_1x01_P2.54mm_Vertical
R6, R7, R8, R9, R10, R11, R12, R13, R14, R15, R16, R17, R18, R19, R20, R21, R22, R23, R24: 50, 1/8W; R_0805_2012Metric

Connections:
/Entradas/Data_SensorCO2: C6.1, R16.2; also elsewhere on the board
/Entradas/Data_SensorFlujo: C11.1, R23.2; also elsewhere on the board
/Entradas/Data_SensorNivel_1: R7.2; also elsewhere on the board
/Entradas/Data_SensorNivel_2: R9.2; also elsewhere on the board
/Entradas/Data_SensorNivel_3: R11.2; also elsewhere on the board
/Entradas/Data_SensorNivel_4: R13.2; also elsewhere on the board
/Entradas/Data_SensorNivel_5: R15.2; also elsewhere on the board
/Entradas/Data_SensorTempHum: R22.2; also elsewhere on the board
/Entradas/Data_SensorTempSumerg: R18.2; also elsewhere on the board
/Entradas/Ilum_Analog: C9.1, R20.2; also elsewhere on the board
/Entradas/SensorCO2: R16.1; also elsewhere on the board
/Entradas/SensorFlujo: R23.1; also elsewhere on the board
/Entradas/SensorIlum: R20.1; also elsewhere on the board
/Entradas/SensorNivel_1: R6.1; also elsewhere on the board
/Entradas/SensorNivel_2: R8.1; also elsewhere on the board
/Entradas/SensorNivel_3: R10.1; also elsewhere on the board
/Entradas/SensorNivel_4: R12.1; also elsewhere on the board
/Entradas/SensorNivel_5: R14.1; also elsewhere on the board
/Entradas/SensorTDS: R19.1; also elsewhere on the board
/Entradas/SensorTempHum: R21.1; also elsewhere on the board
/Entradas/SensorTempSumerg: R17.1; also elsewhere on the board
/Entradas/SensorpH: R24.1; also elsewhere on the board
/Entradas/TDS_Analog: C8.1, R19.2; also elsewhere on the board
/Entradas/pH__Analog: C12.1, R24.2; also elsewhere on the board
GND: C1.2, C2.2, C3.2, C4.2, C5.2, C6.2, C7.2, C8.2, C9.2, C10.2, C11.2, C12.2, J26.1, J37.1, J38.1, J39.1, J40.1, J41.1, J42.1, J46.1, J47.1; also elsewhere on the board
unnamed: C1.1, R6.2, R7.1
unnamed: C2.1, R8.2, R9.1
unnamed: C3.1, R10.2, R11.1
unnamed: C4.1, R12.2, R13.1
unnamed: C5.1, R14.2, R15.1
unnamed: C7.1, R17.2, R18.1
unnamed: C10.1, R21.2, R22.1

Notes on the sheet:
Filtrado de señales analógicas y digitales de sensores

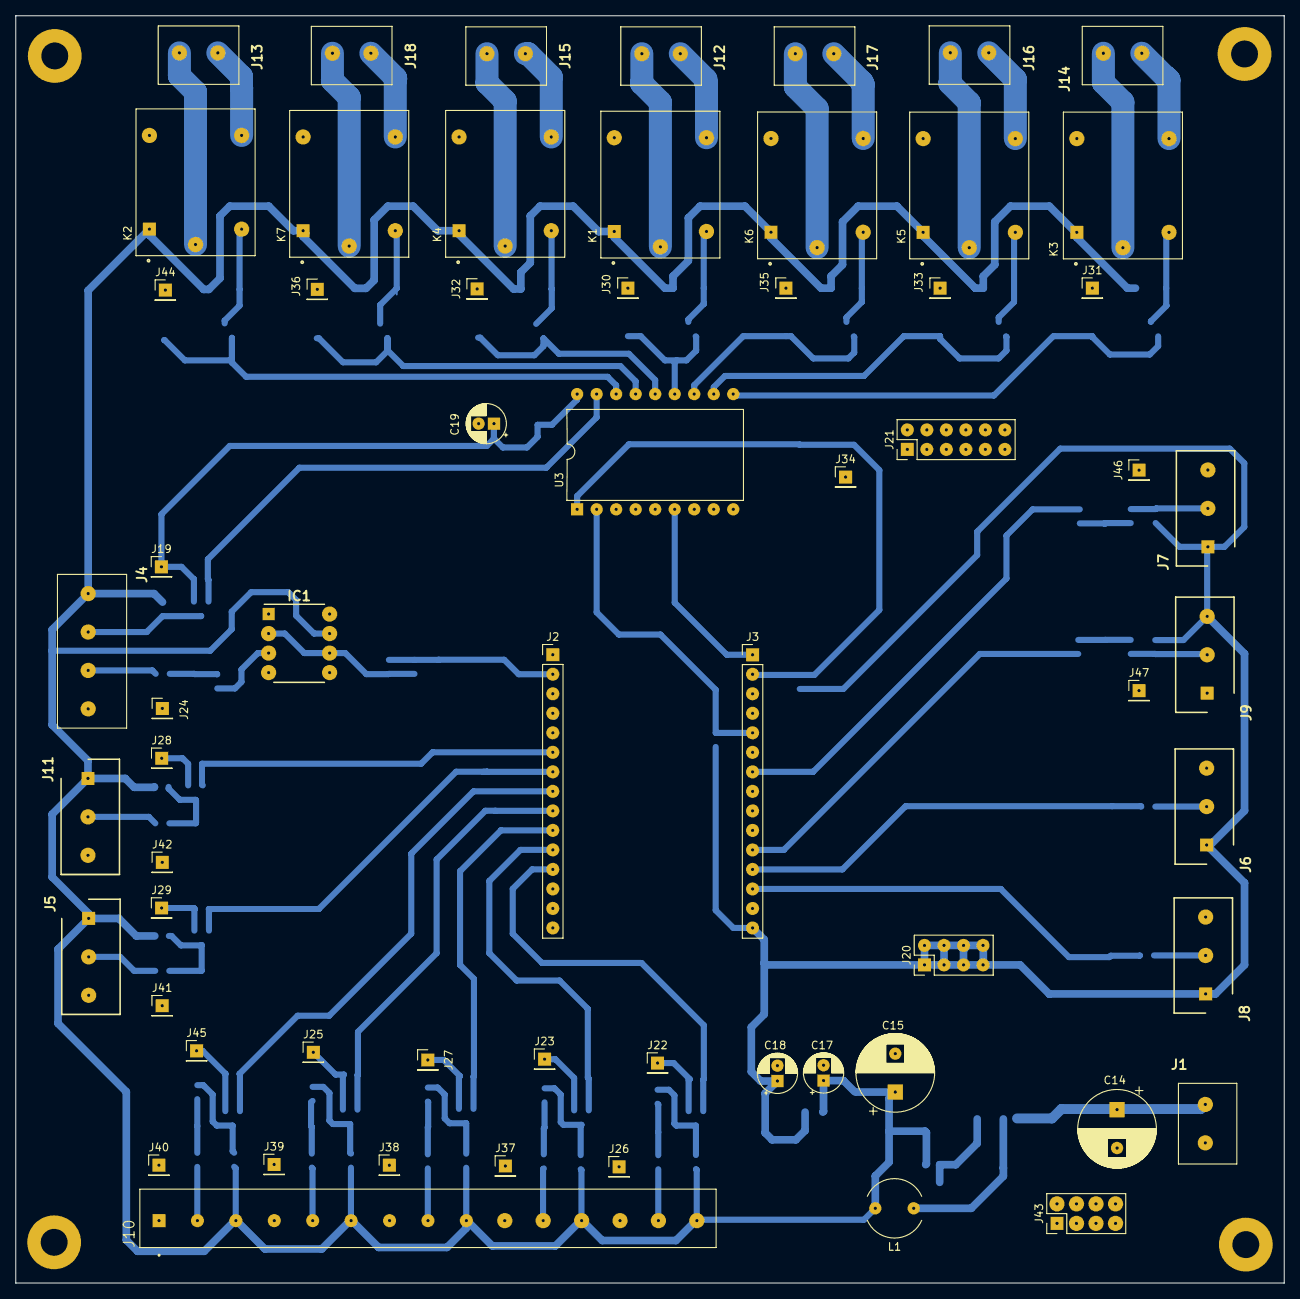
[picture p16: board PCB_Prototipo_Proyecto_Final.kicad_pcb from above]

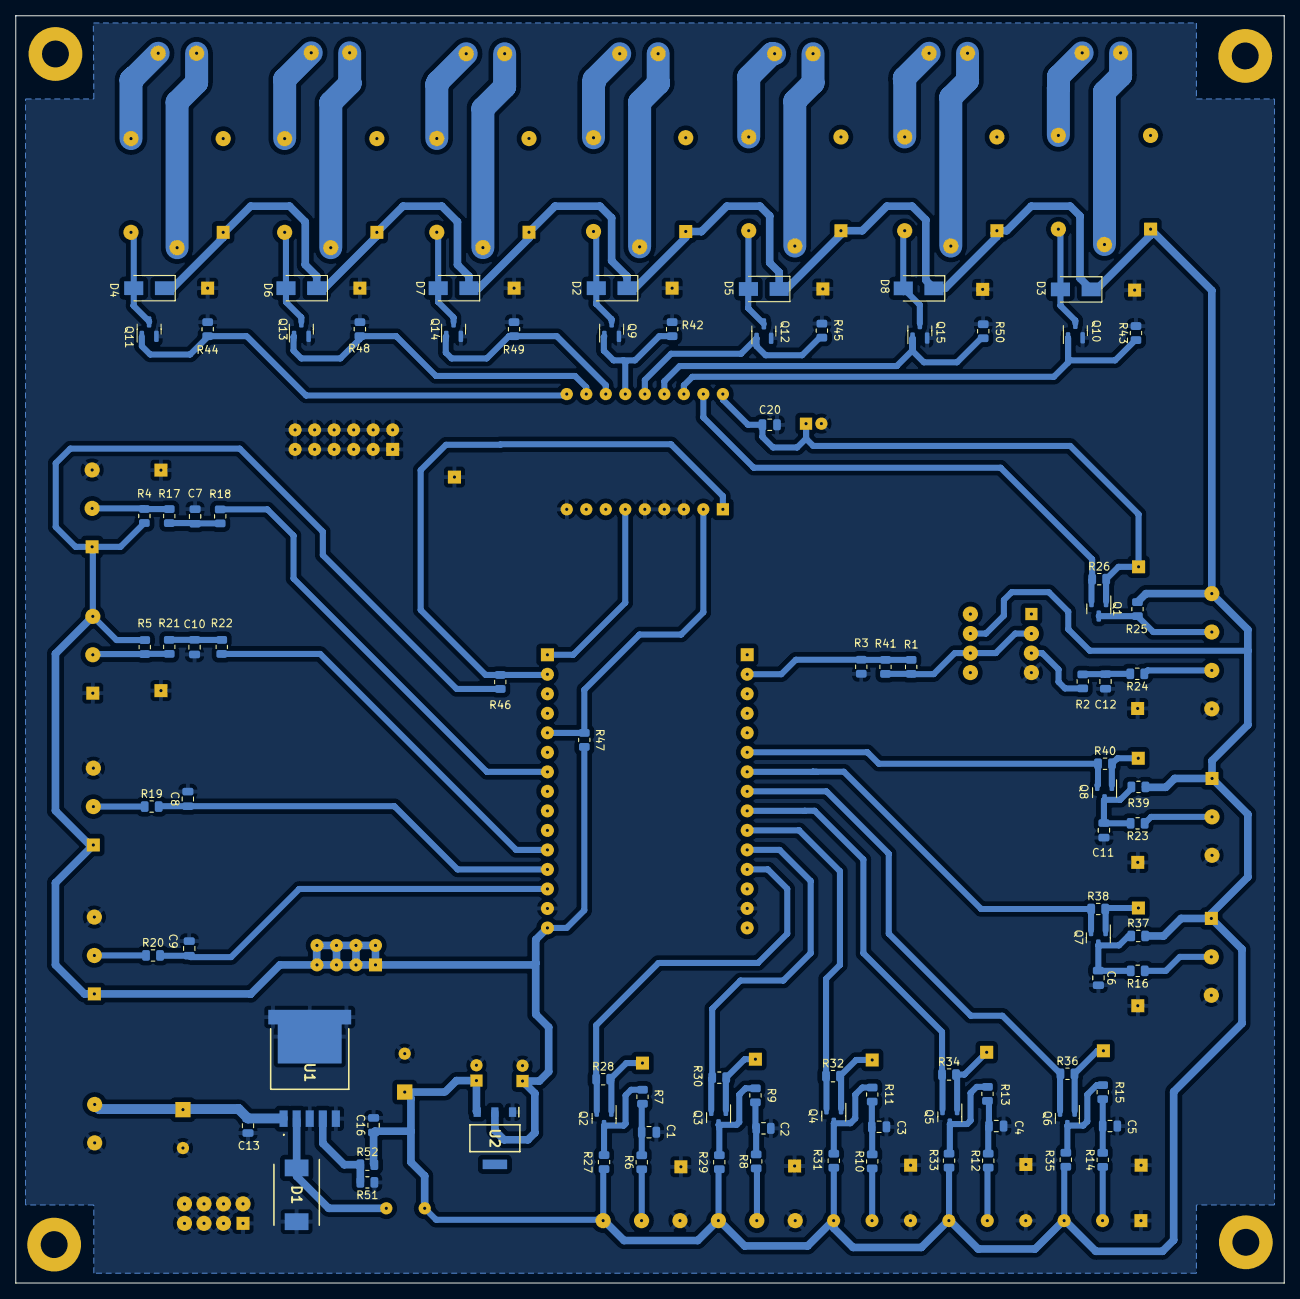
[picture p17: board PCB_Prototipo_Proyecto_Final.kicad_pcb from below]

Board: 2 copper layers, 165.1 x 164.9 mm, 154 parts (92 on the bottom side), 80 nets.
