FrancoBisciglia/ProyectoFinal_PCB_Prototipo/(commit log)

2022-09-23 Carga inicial de archivos
    [Entradas.kicad_sch, Filtrado.kicad_sch, Fuentes.kicad_sch, Interfaces_GPIO.kicad_sch, Microcontrolador.kicad_sch, PCB_Prototipo_Proyecto_Final.kicad_pcb, PCB_Prototipo_Proyecto_Final.kicad_sch, Rele_1.kicad_sch]
2022-09-23 Ajuste del esquematico
    Se cambio el integrado ESP32 por 2 tiras de pines de 1x15, se quitaron los switches EN y BOOT que ya estan en el NodeMCU, se quito el mutliplexor 74HC y se cablearon las I/O
    [Filtrado.kicad_sch, Interfaces_GPIO.kicad_sch, Microcontrolador.kicad_sch, PCB_Prototipo_Proyecto_Final.kicad_sch, Rele_1.kicad_sch, Rele_2.kicad_sch, Rele_3.kicad_sch, Rele_4.kicad_sch]
2022-09-24 Subida de backups
2022-09-24 Modificación de posición de circ. filtrado y circ. de adaptación de tensión
    [Adaptacion_tension_señales.kicad_sch, Entradas.kicad_sch, Filtrado.kicad_sch, Interfaces_GPIO.kicad_sch, Microcontrolador.kicad_sch, PCB_Prototipo_Proyecto_Final.kicad_sch, Rele_1.kicad_sch, Rele_2.kicad_sch]
2022-09-24 Corrección de errores menores de esquematico
    [Adaptacion_tension_señales.kicad_sch, Entradas.kicad_sch, Filtrado.kicad_sch, Fuentes.kicad_sch, Interfaces_GPIO.kicad_sch, Microcontrolador.kicad_sch, PCB_Prototipo_Proyecto_Final.kicad_sch, Rele_1.kicad_sch]
2022-10-01 Actualización de SCH según placa industrial, y búsqueda de footprints.
    [Adaptacion_tension_señales.kicad_sch, Entradas.kicad_sch, Filtrado.kicad_sch, Fuentes.kicad_sch, Interfaces_GPIO.kicad_sch, Microcontrolador.kicad_sch, PCB_Prototipo_Proyecto_Final.kicad_sch, Rele_1.kicad_sch]
2022-10-03 Fin de SCH, config de inicio para PCB
    [Entradas.kicad_sch, Filtrado.kicad_sch, Fuentes.kicad_sch, Microcontrolador.kicad_sch, PCB_Prototipo_Proyecto_Final.kicad_pcb, PCB_Prototipo_Proyecto_Final.kicad_sch, Rele_1.kicad_sch, Rele_2.kicad_sch]
2022-10-03 Inicio de trazado de PCB
    Se empezaron a acomodar los footprints.
    [Fuentes.kicad_sch, Microcontrolador.kicad_sch, PCB_Prototipo_Proyecto_Final.csv, PCB_Prototipo_Proyecto_Final.kicad_pcb]
2022-10-07 Cambios en SCH y PCB.
    Se cambio el adaptador de nivel 5-3,3V por un circuito con MOSFET 2N7002, dado que ya no hay stock del NXB. Se modificó el footprint del expansor I/O por uno thorugh-hole.
    [Adaptacion_tension_señales.kicad_sch, Entradas.kicad_sch, Interfaces_GPIO.kicad_sch, Microcontrolador.kicad_sch, PCB_Prototipo_Proyecto_Final.kicad_pcb, PCB_Prototipo_Proyecto_Final.kicad_sch, Rele_1.kicad_sch, Rele_2.kicad_sch]
2022-10-07 Continuación de trazado de PCB.
    [PCB_Prototipo_Proyecto_Final.kicad_pcb]
2022-10-09 Se finalizó con el PCB del prototipo.
    Dado que se buscó a toda costa que el PCB fuera de 1 capa, en varios puntos del circuito se tuvieron que agregar pin headers individuales para conectar a 3V3 y GND, junto con tiras de pin headers. Cada una de estas se conectara luego entre si mediante cables.
    Tambien se generaron los archivos Gerber y BOM.
    [Adaptacion_tension_señales.kicad_sch, Entradas.kicad_sch, Filtrado.kicad_sch, Fuentes.kicad_sch, Interfaces_GPIO.kicad_sch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]
2022-10-13 Se modificaron los footprints del capacitor de 470 uF y del LM1117.
    [Fuentes.kicad_sch, PCB_Prototipo_Proyecto_Final.kicad_pcb, PCB_Prototipo_Proyecto_Final.kicad_sch]
2022-10-14 Se modificaron algunos componentes, según disponibilidad
    [Adaptacion_tension_señales.kicad_sch, Entradas.kicad_sch, Filtrado.kicad_sch, Fuentes.kicad_sch, Interfaces_GPIO.kicad_sch, PCB_Prototipo_Proyecto_Final.kicad_sch, Rele_1.kicad_sch, Rele_2.kicad_sch]
2022-10-15 Modificación de componentes.
    Se agregó al PCB los footprints de los componentes que se cambiaron según la disponibilidad que había (resistencias, transistor de los relés, diodo de los reles)
    [PCB_Prototipo_Proyecto_Final.kicad_pcb]
2022-10-15 Se cambiaron todos los componentes a la capa BOTTOM.
    [PCB_Prototipo_Proyecto_Final.kicad_pcb]
2022-10-16 Modificacion de PCB.
    Me di cuenta que, al pasar los componentes SMD y las pistas al lado BOTTOM, los componentes TH quedaron todos al revés, por lo que será necesario rediseñar la PCB para acomodarlos del lado TOP correctamente.
    [PCB_Prototipo_Proyecto_Final.kicad_pcb]
2022-10-17 Inicio de rerouteo.
    [Entradas.kicad_sch, PCB_Prototipo_Proyecto_Final.kicad_pcb]
2022-10-17 Continuación de rerouteo.
    [PCB_Prototipo_Proyecto_Final.kicad_pcb]
2022-10-17 Finalización de rerouteo de PCB.
    [Adaptacion_tension_señales.kicad_sch, Interfaces_GPIO.kicad_sch, Microcontrolador.kicad_sch, PCB_Prototipo_Proyecto_Final.kicad_pcb, PCB_Prototipo_Proyecto_Final.kicad_sch, Rele_7.kicad_sch]
2022-10-20 Actualización de backups.
    [Filtrado.kicad_sch]
2022-10-21 Correccion footprints
    Se realizo el cambio de algunas footprints segun los componentes disponibles, como los capacitores de 470 uF o la inductancia de la fte switching, y tambien se cambio el LM2596 por el modelo ADJ, con el agregado de un divisor resistivo.
    [Fuentes.kicad_sch, Interfaces_GPIO.kicad_sch, PCB_Prototipo_Proyecto_Final.kicad_pcb, PCB_Prototipo_Proyecto_Final.kicad_sch]
2022-10-22 Corrección de PCB.
    Se agregaron algunos pin headers para conectar a GND algunos puntos. Se generaron los Gerber finales.
    [Filtrado.kicad_sch, Fuentes.kicad_sch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]
2022-10-24 Actualizacion de backups
2022-10-24 Modificación de footprint del MCP23008
    Se lo modifico de forma de poder utilizar el adaptador SOP/PDIP, ya que tiene un ancho de 1,5 cm, que es más grande que el PDIP solo.
    [PCB_Prototipo_Proyecto_Final.kicad_pcb]
2022-10-24 Generación de Gerber y Drill files.
    [PCB_Prototipo_Proyecto_Final-B_Cu.gbr, PCB_Prototipo_Proyecto_Final-B_Mask.gbr, PCB_Prototipo_Proyecto_Final-B_Paste.gbr, PCB_Prototipo_Proyecto_Final-B_Silkscreen.gbr, PCB_Prototipo_Proyecto_Final-Edge_Cuts.gbr, PCB_Prototipo_Proyecto_Final-F_Cu.gbr, PCB_Prototipo_Proyecto_Final-F_Mask.gbr, PCB_Prototipo_Proyecto_Final-F_Paste.gbr]
2022-10-24 Actualización de PCB y regeneración de Gerbers y Drill
    [PCB_Prototipo_Proyecto_Final-B_Cu.gbr, PCB_Prototipo_Proyecto_Final-B_Mask.gbr, PCB_Prototipo_Proyecto_Final-B_Paste.gbr, PCB_Prototipo_Proyecto_Final-B_Silkscreen.gbr, PCB_Prototipo_Proyecto_Final-Edge_Cuts.gbr, PCB_Prototipo_Proyecto_Final-F_Cu.gbr, PCB_Prototipo_Proyecto_Final-F_Mask.gbr, PCB_Prototipo_Proyecto_Final-F_Paste.gbr]
2022-10-27 Corrección de errores menores de pistas.
    [PCB_Prototipo_Proyecto_Final.kicad_pcb]
2022-11-01 Corrección de errores menores y generación de Gerbers.
    [PCB_Prototipo_Proyecto_Final-B_Cu.gbr, PCB_Prototipo_Proyecto_Final-B_Mask.gbr, PCB_Prototipo_Proyecto_Final-B_Paste.gbr, PCB_Prototipo_Proyecto_Final-B_Silkscreen.gbr, PCB_Prototipo_Proyecto_Final-Edge_Cuts.gbr, PCB_Prototipo_Proyecto_Final-F_Cu.gbr, PCB_Prototipo_Proyecto_Final-F_Mask.gbr, PCB_Prototipo_Proyecto_Final-F_Paste.gbr]
2023-03-13 Cambios modelos 3D.
    [Entradas.kicad_sch, PCB_Prototipo_Proyecto_Final.kicad_pcb, PCB_Prototipo_Proyecto_Final.kicad_sch]
